Hector-S/ECE411-Practicum/Real-World Documentation/Board Assembled.jpg

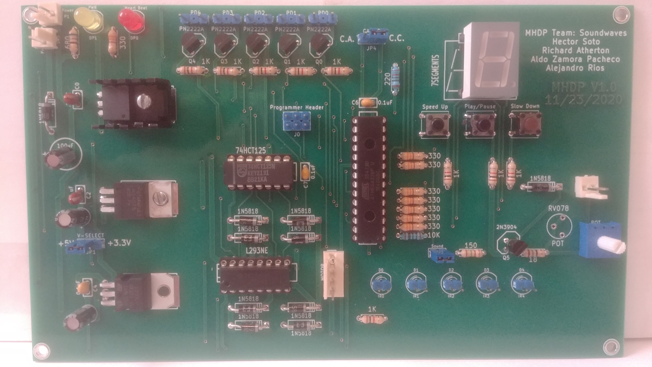
Real-World Documentation/Board Assembled.jpg
