Hector-S/ECE411-Practicum/Schematics/Final Project Schematic/MHDP_Layout_Quasi.JPG

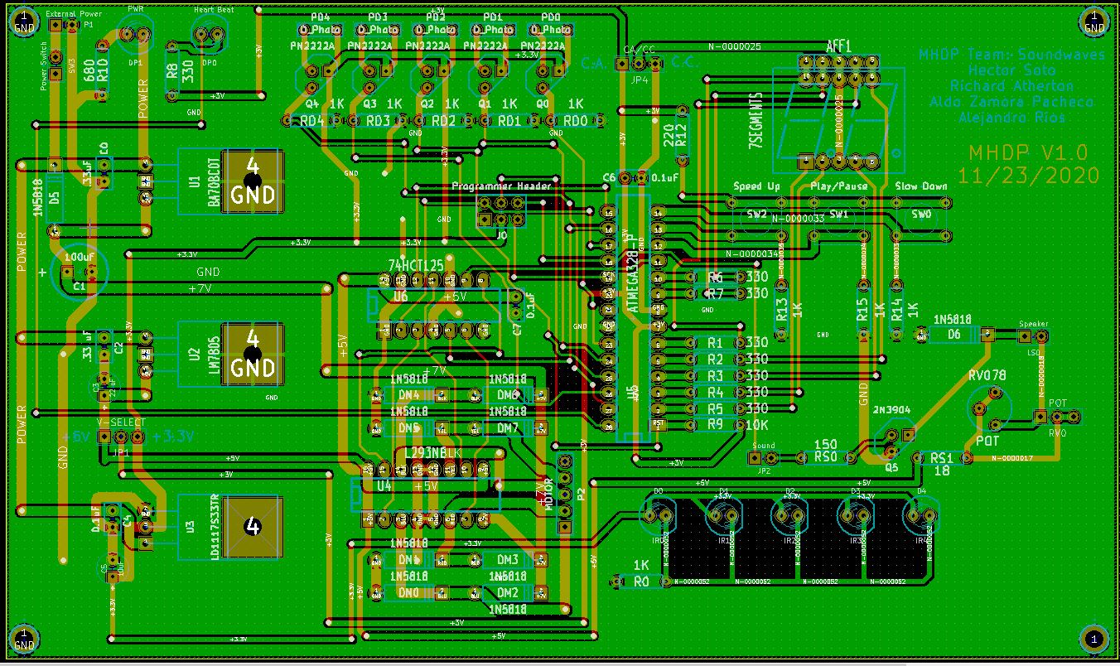
Schematics/Final Project Schematic/MHDP_Layout_Quasi.JPG
