Hector-S/ECE411-Practicum/README.md

# ECE411-Practicum
* **Team Members**
  * Aldo Zamora Pacheco
  * Alejandro (Alex) Rios
  * Hector Soto
  * Richard Atherton

License: GNU General Public License v3.0
