Hector-S/ECE411-Practicum/Documentation/Block Diagrams/MHDP Block Diagram.pdf

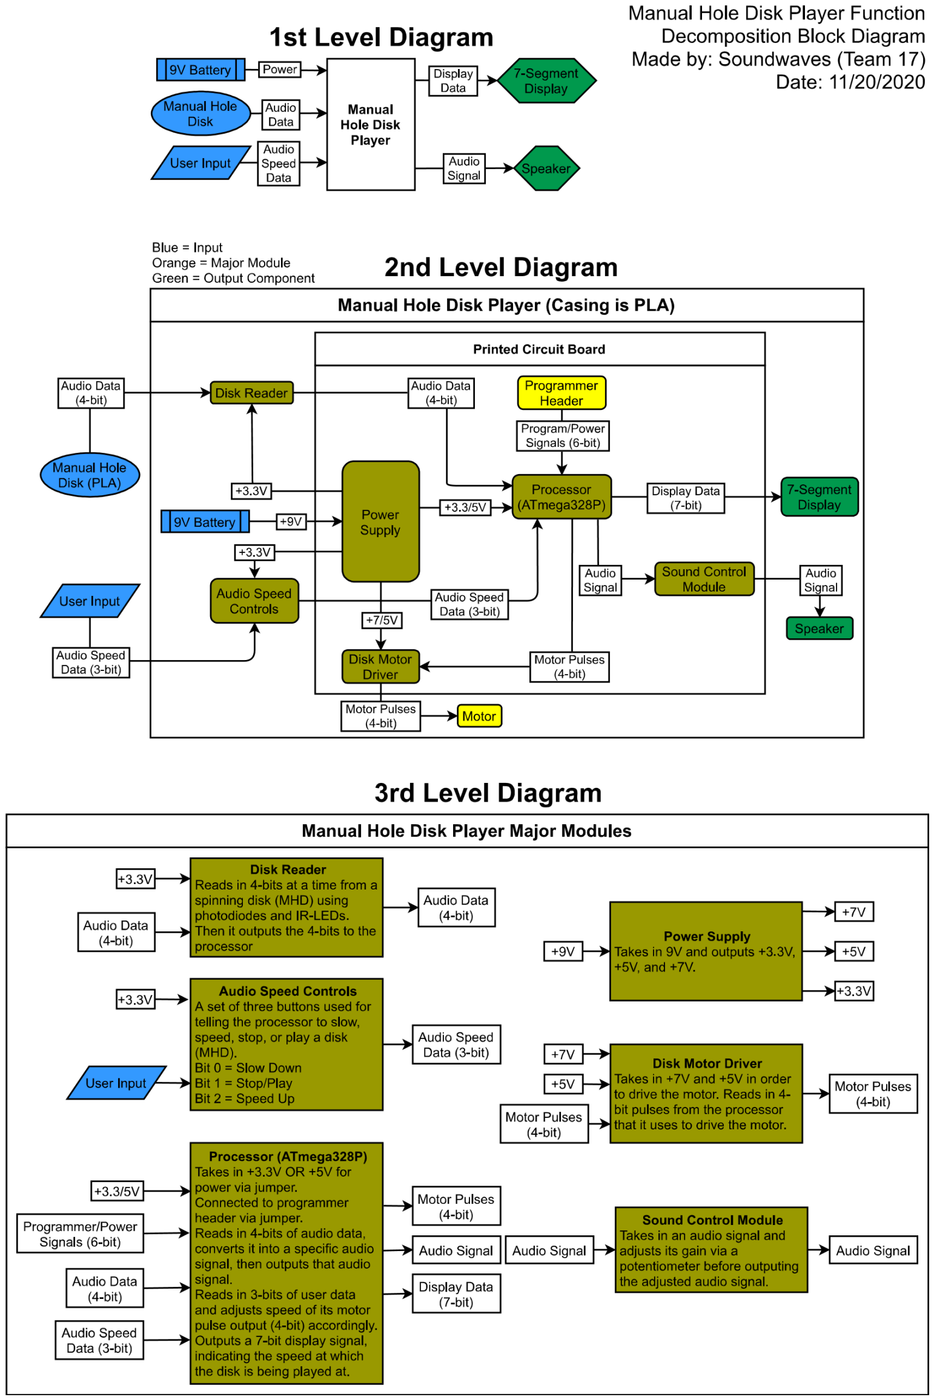
[picture p4: page 1]
