Hector-S/ECE411-Practicum/Circuit/SoundControl/IMG_8013.jpg

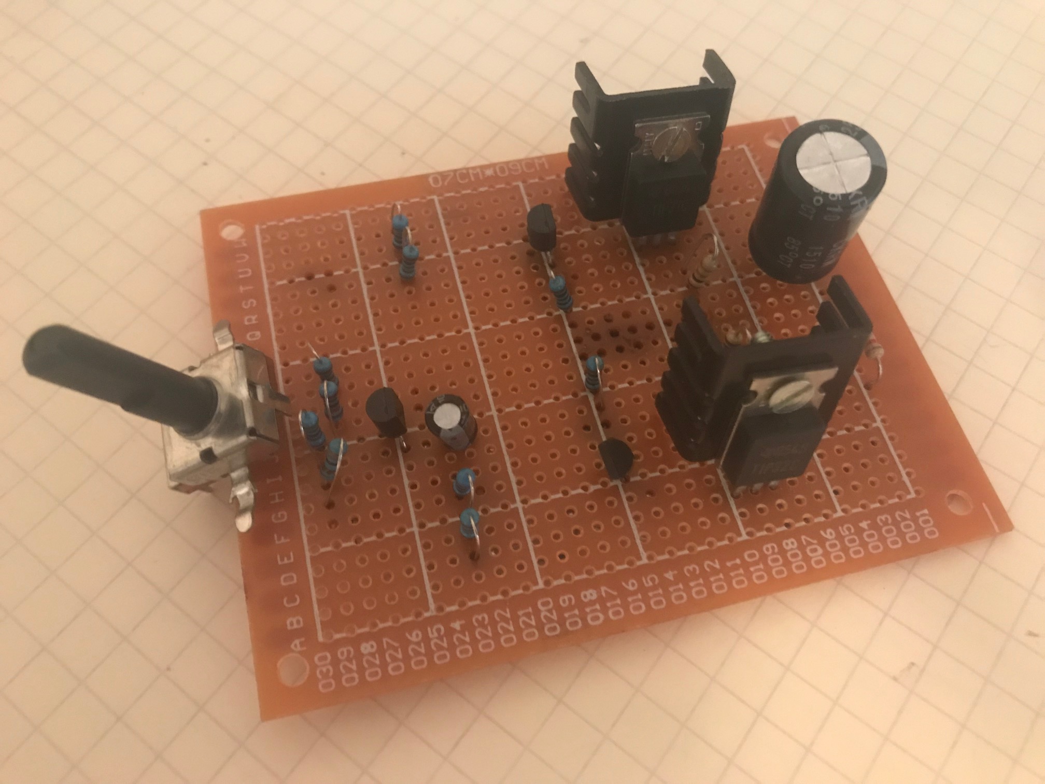
Circuit/SoundControl/IMG_8013.jpg
