Hector-S/ECE411-Practicum/Documentation/Block Diagrams/MHDP Block Diagram.jpg

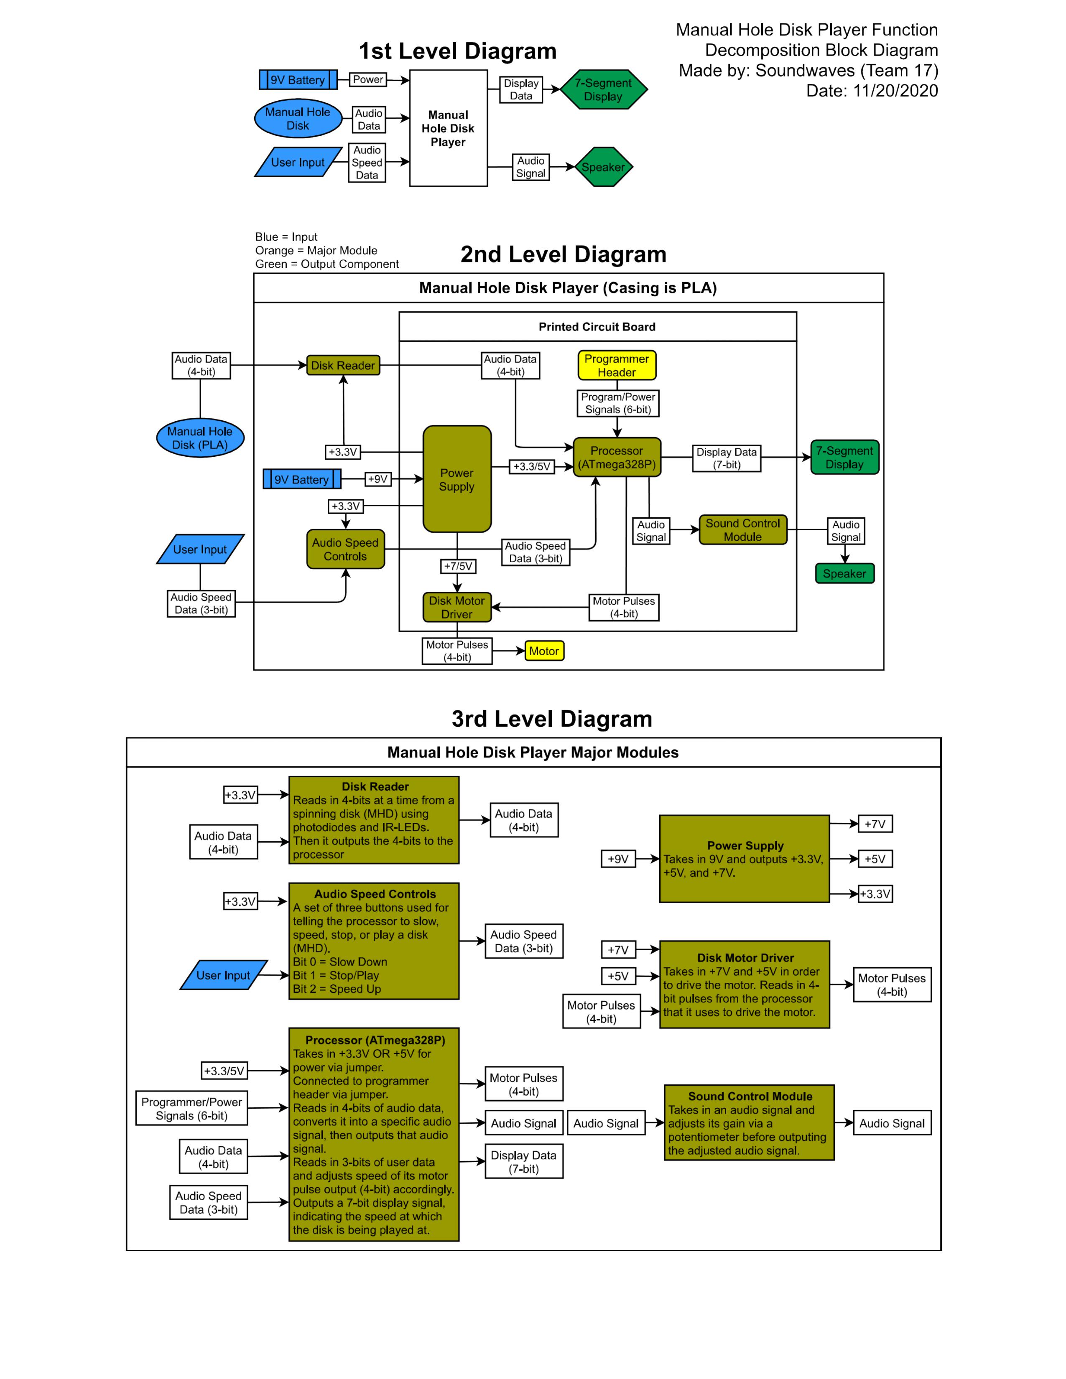
Documentation/Block Diagrams/MHDP Block Diagram.jpg
