Hector-S/ECE411-Practicum/Documentation/Block Diagrams/Motor Speed State Diagram.PNG

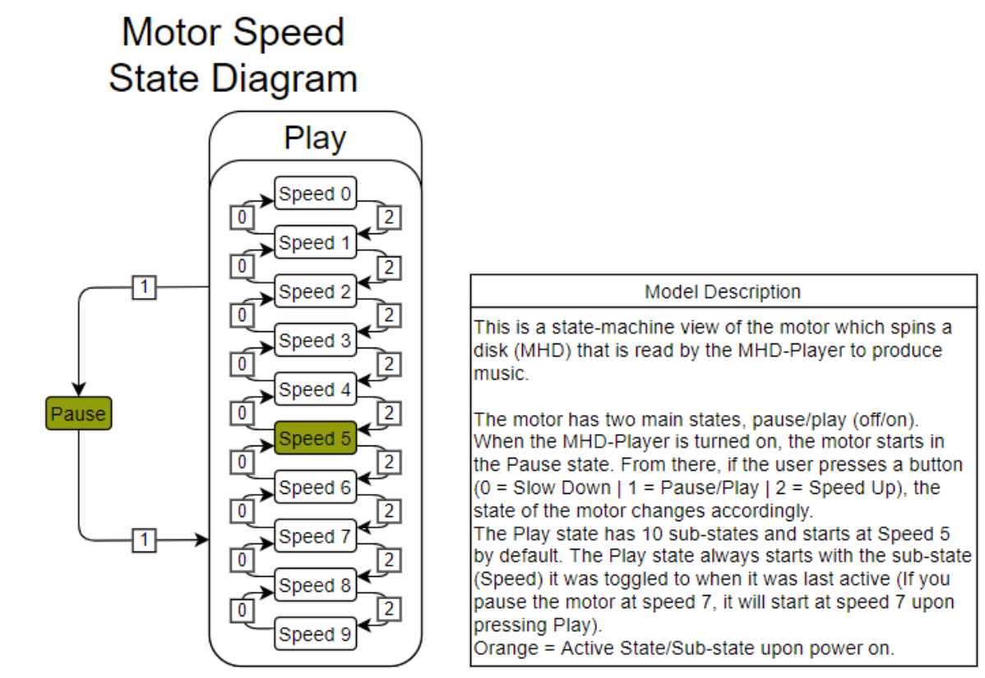
Documentation/Block Diagrams/Motor Speed State Diagram.PNG
