Hector-S/ECE411-Practicum/Real-World Documentation/Board Back.jpg

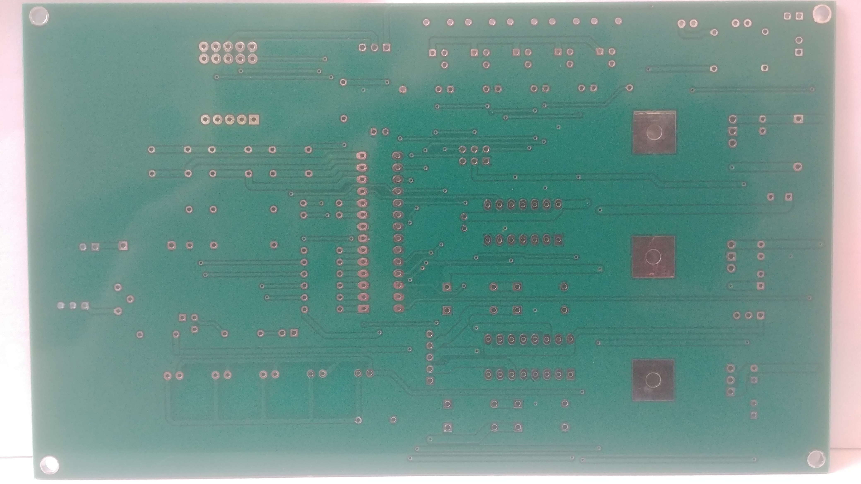
Real-World Documentation/Board Back.jpg
