Hector-S/ECE411-Practicum/Real-World Documentation/Board Front.jpg

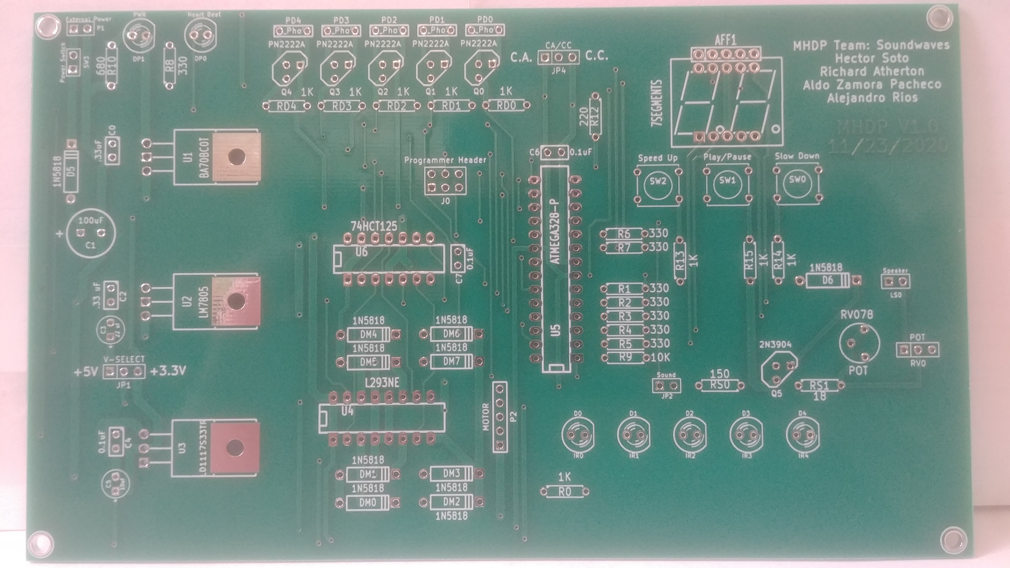
Real-World Documentation/Board Front.jpg
