Hector-S/ECE411-Practicum/Schematics/Beta Project Schematic/Rough_Draft_Schematic.jpg

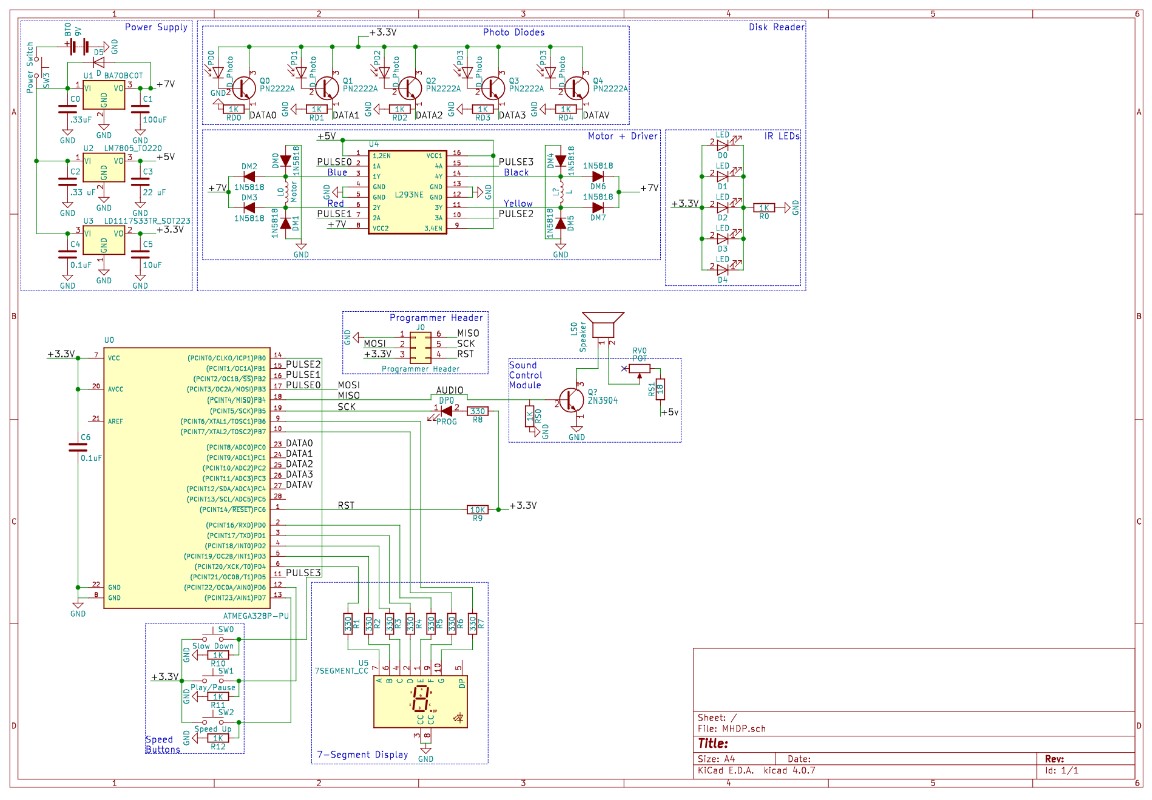
Schematics/Beta Project Schematic/Rough_Draft_Schematic.jpg
