Hector-S/ECE411-Practicum/Schematics/Complete Project Schematic.PNG

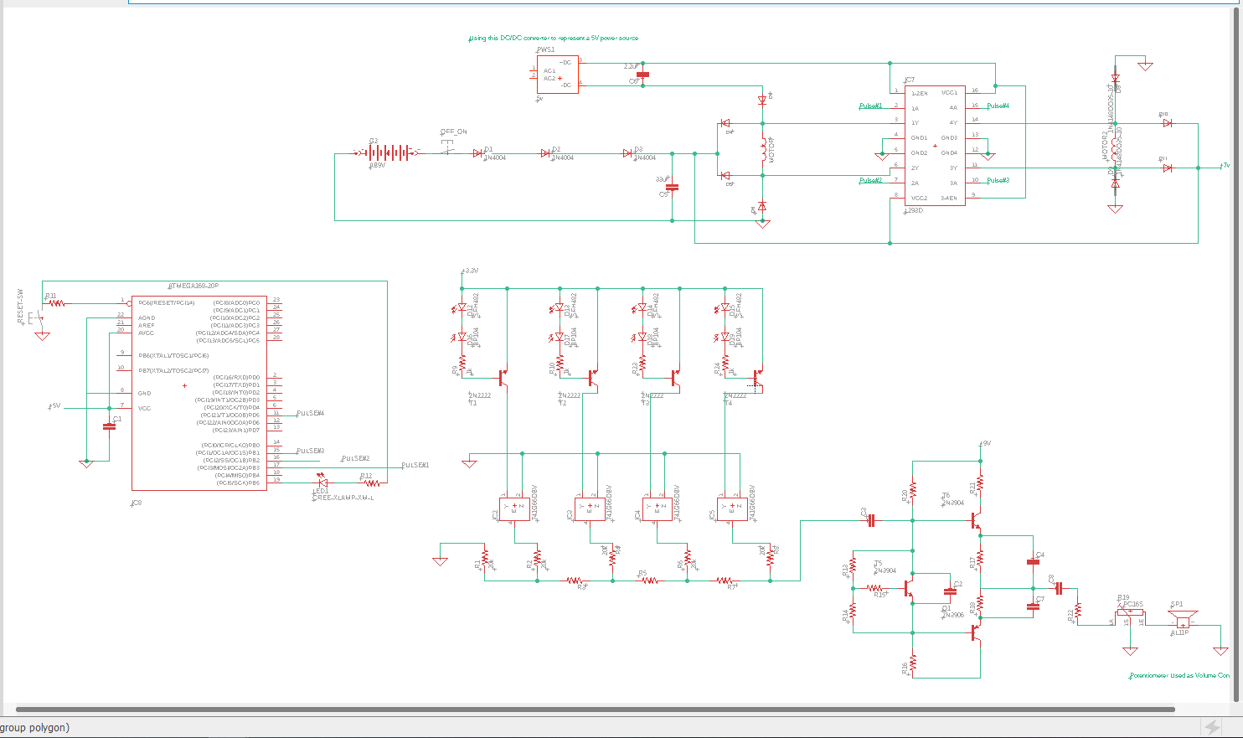
Schematics/Complete Project Schematic.PNG
