Hector-S/ECE411-Practicum/Schematics/Final Project Schematic/Final Schematic.png

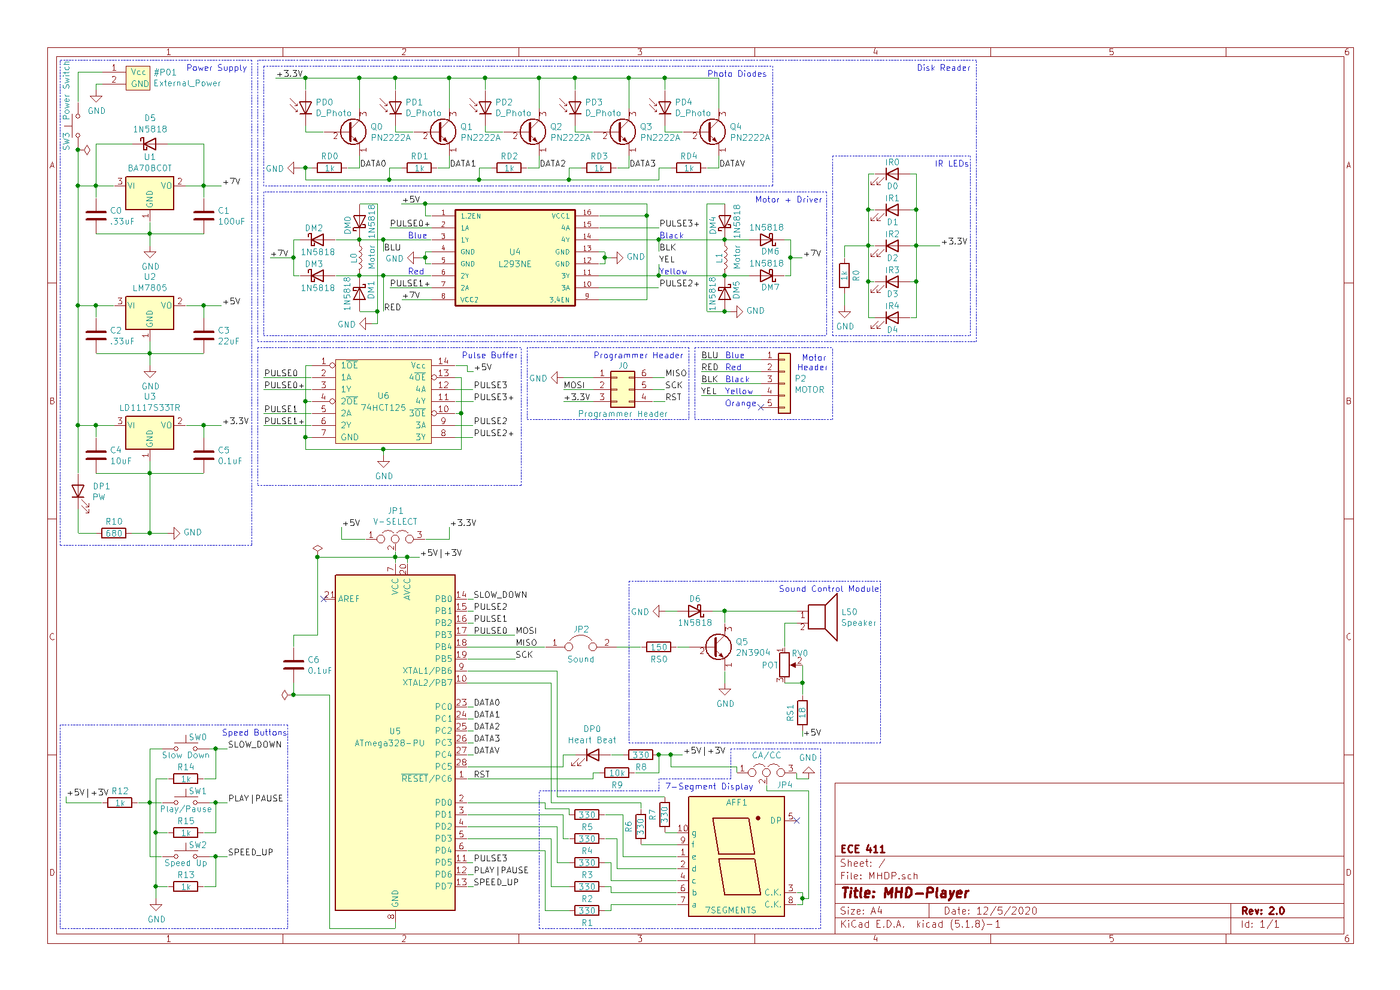
Schematics/Final Project Schematic/Final Schematic.png
