Hector-S/ECE411-Practicum/Schematics/Final Project Schematic/MHDP_Layout_Front.png

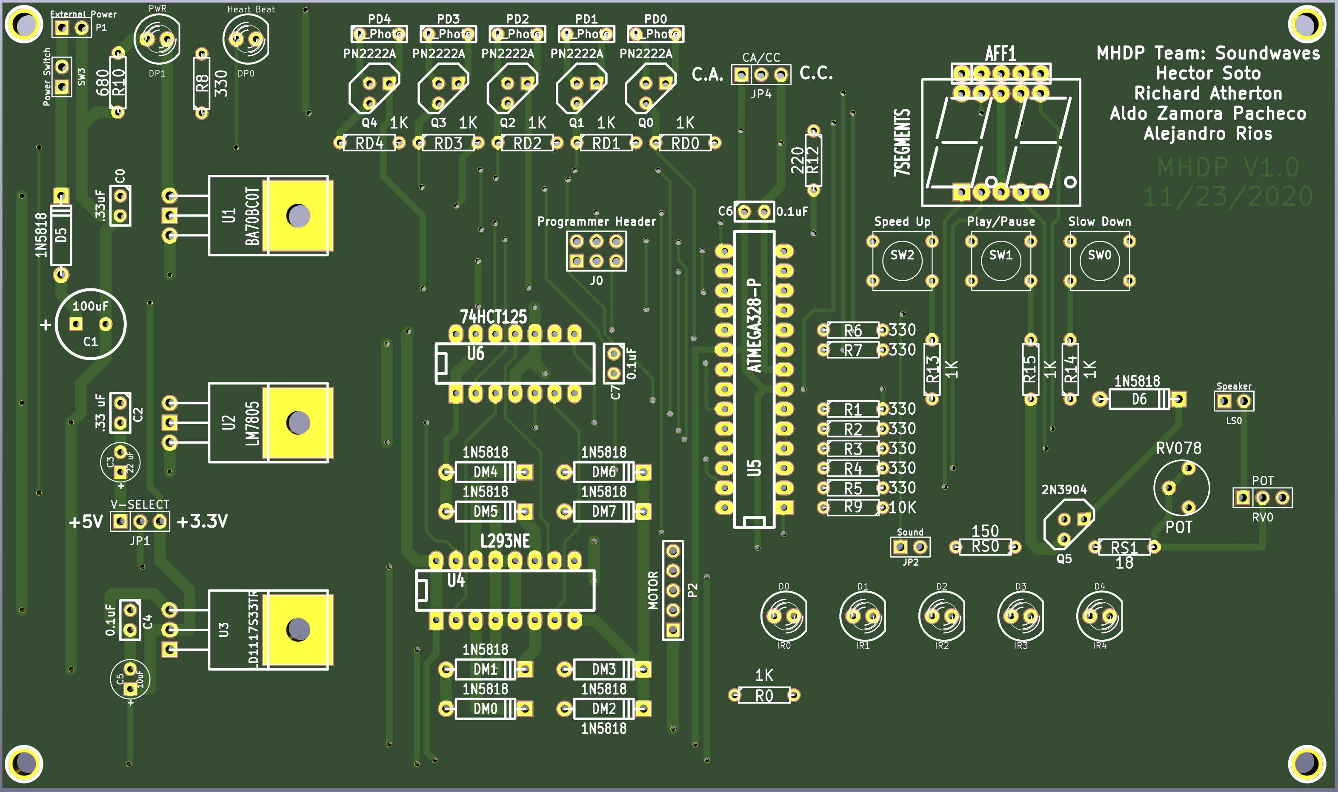
Schematics/Final Project Schematic/MHDP_Layout_Front.png
