Hector-S/ECE411-Practicum/Schematics/Final Project Schematic/MHDP_Layout_Rear.png

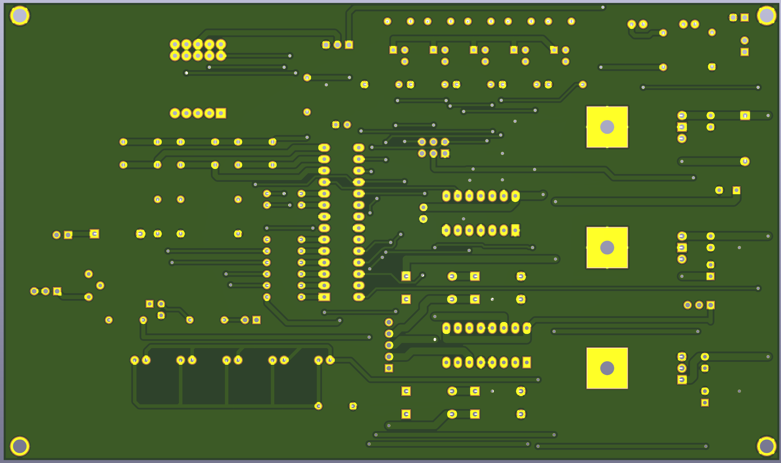
Schematics/Final Project Schematic/MHDP_Layout_Rear.png
