Hector-S/ECE411-Practicum/Documentation/BOM.PNG

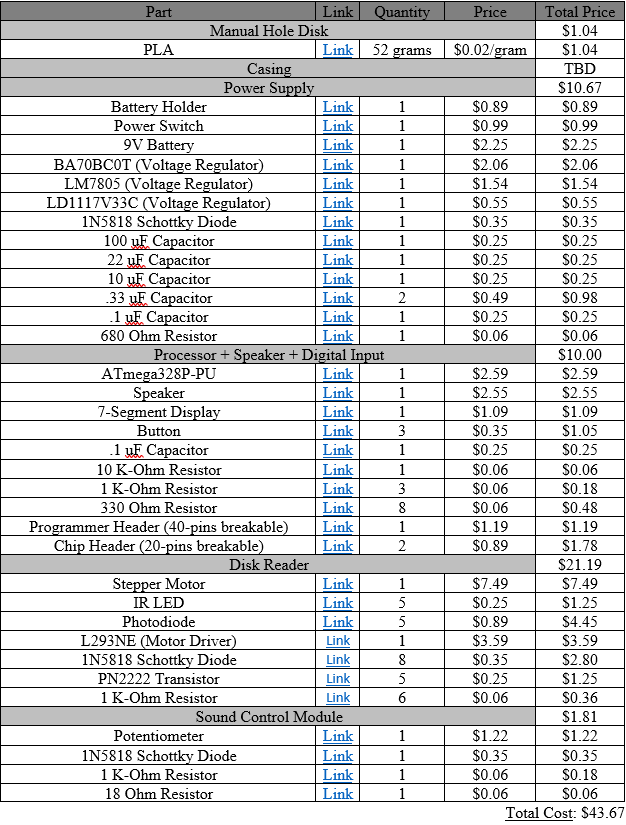
Documentation/BOM.PNG
