Hector-S/ECE411-Practicum/Schematics/Beta Project Schematic/BOM.jpg

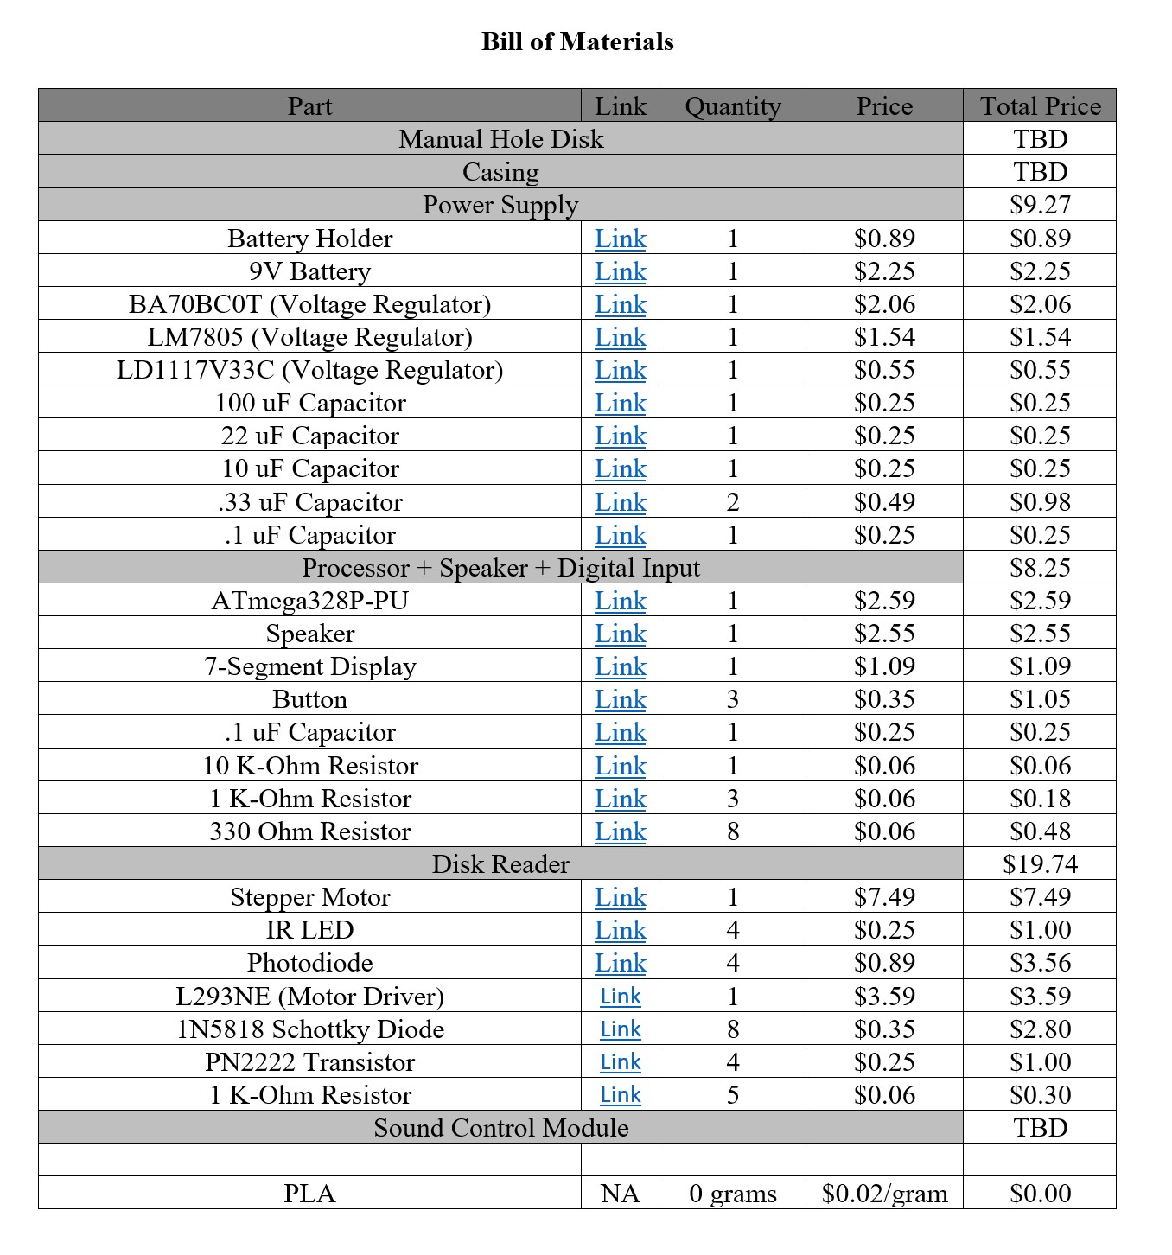
Schematics/Beta Project Schematic/BOM.jpg
