Hector-S/ECE411-Practicum/3D Models/Flap.stl

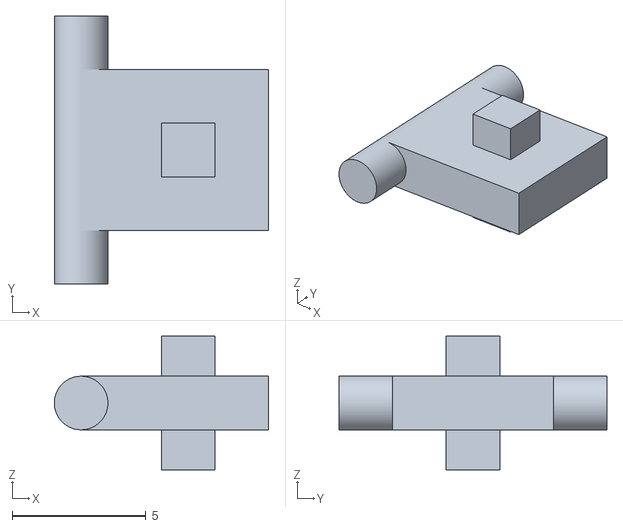
[picture p17: CAD file, 2020-12-05]
3D Models/Flap.stl
8.00 x 10.0 x 5.00
