Hector-S/ECE411-Practicum/Schematics/Beta Project Schematic/L293NE/L293NE.step

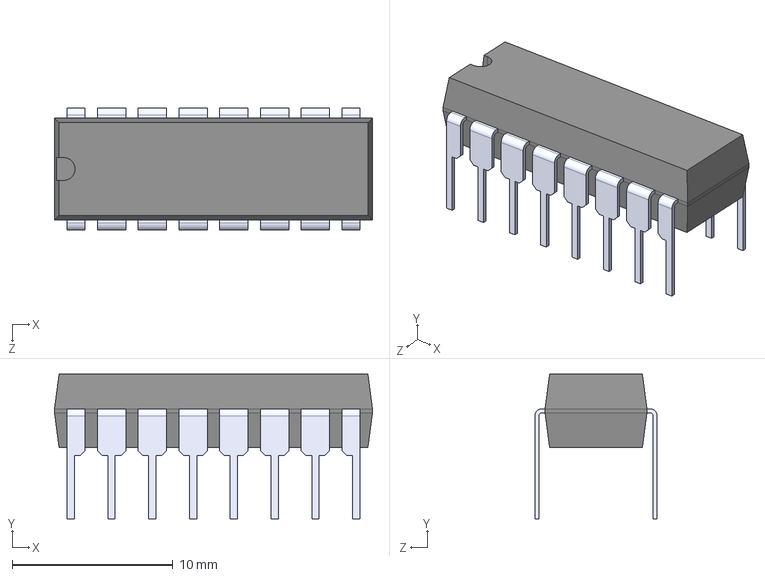
[picture p18: CAD file, 2020-11-18]
Schematics/Beta Project Schematic/L293NE/L293NE.step
19.8 x 9.02 x 7.62 mm
