Hector-S/ECE411-Practicum/3D Models/Disk Lower Half.stl

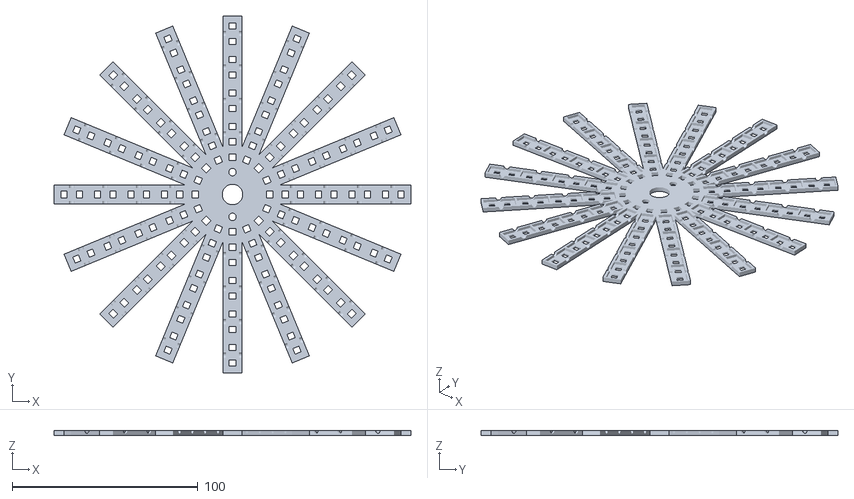
[picture p19: CAD file, 2020-12-05]
3D Models/Disk Lower Half.stl
192.0 x 192.0 x 2.50
