Hector-S/ECE411-Practicum/3D Models/Disk Top Half.stl

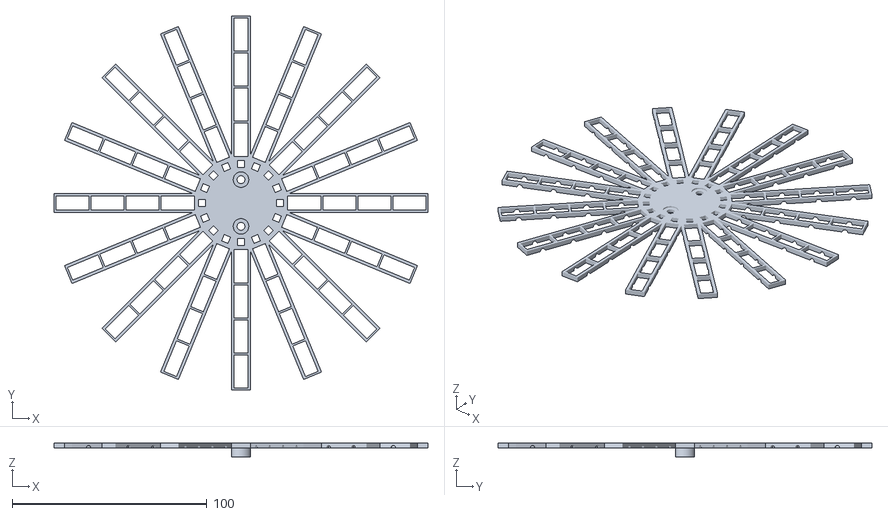
[picture p20: CAD file, 2020-12-05]
3D Models/Disk Top Half.stl
192.0 x 192.0 x 7.00
