Hector-S/ECE411-Practicum/Schematics/Stepper Motor Schematic.pdf

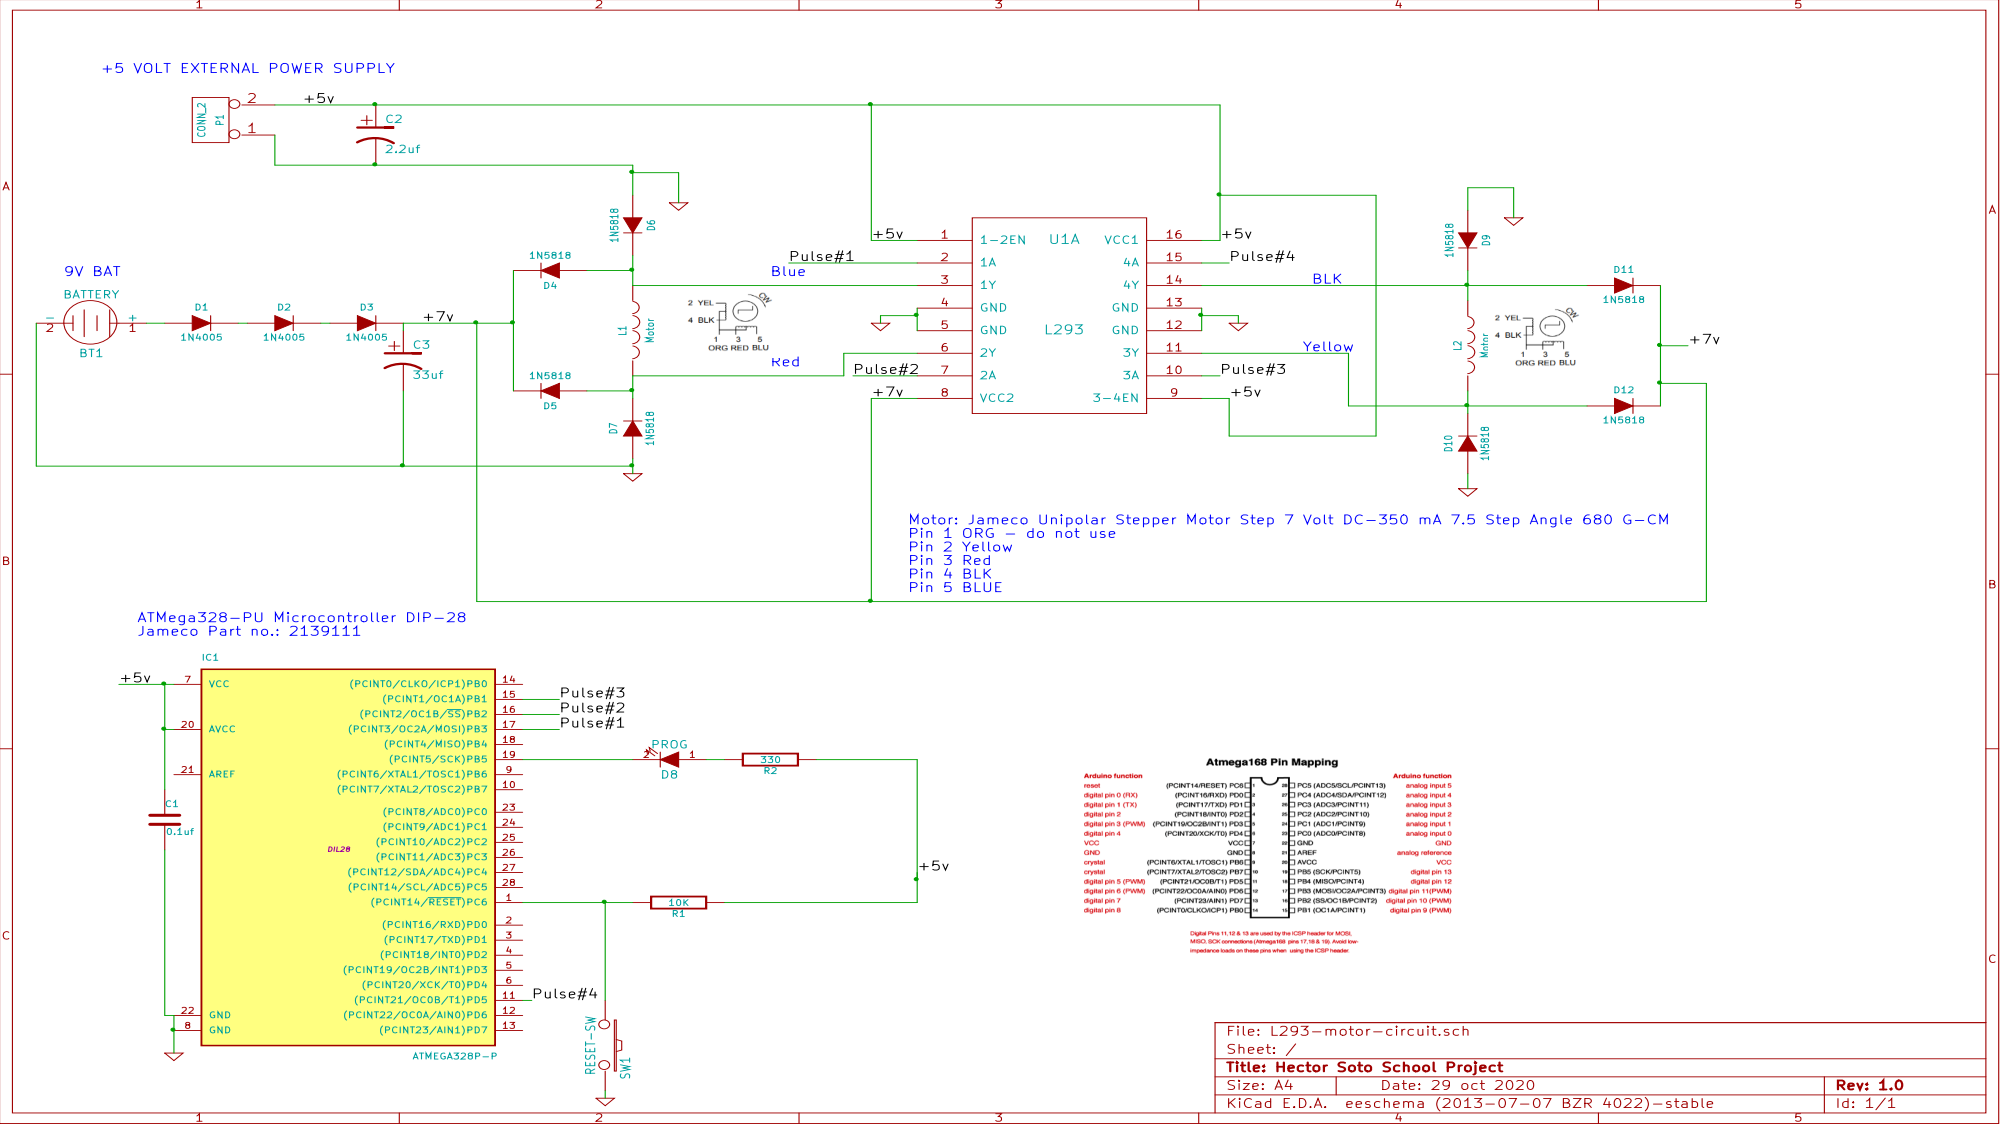
[picture p21: page 1]
