Hector-S/ECE411-Practicum/Schematics/Final Project Schematic/Final Project Schematic.pdf

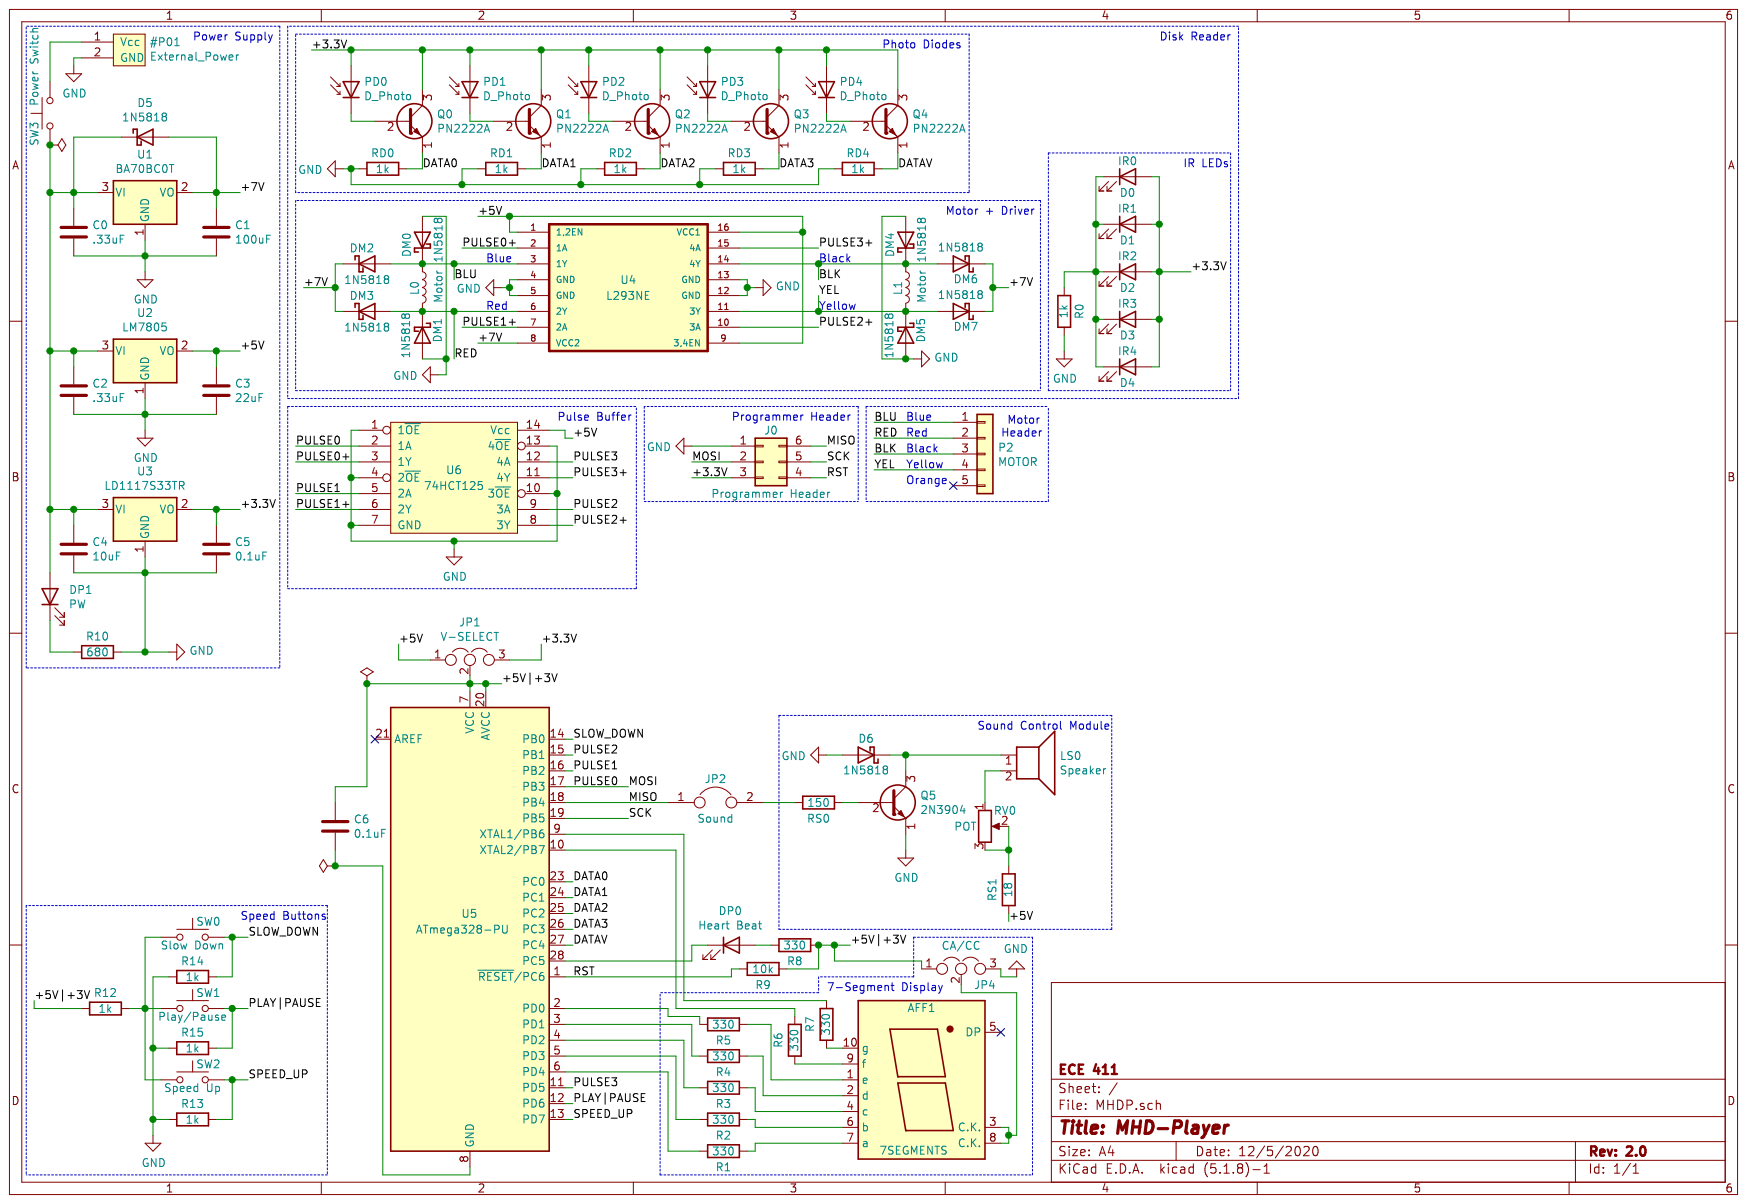
[picture p22: page 1]
