Hector-S/ECE411-Practicum/Schematics/Beta Project Schematic/Final Project Schematic.pdf

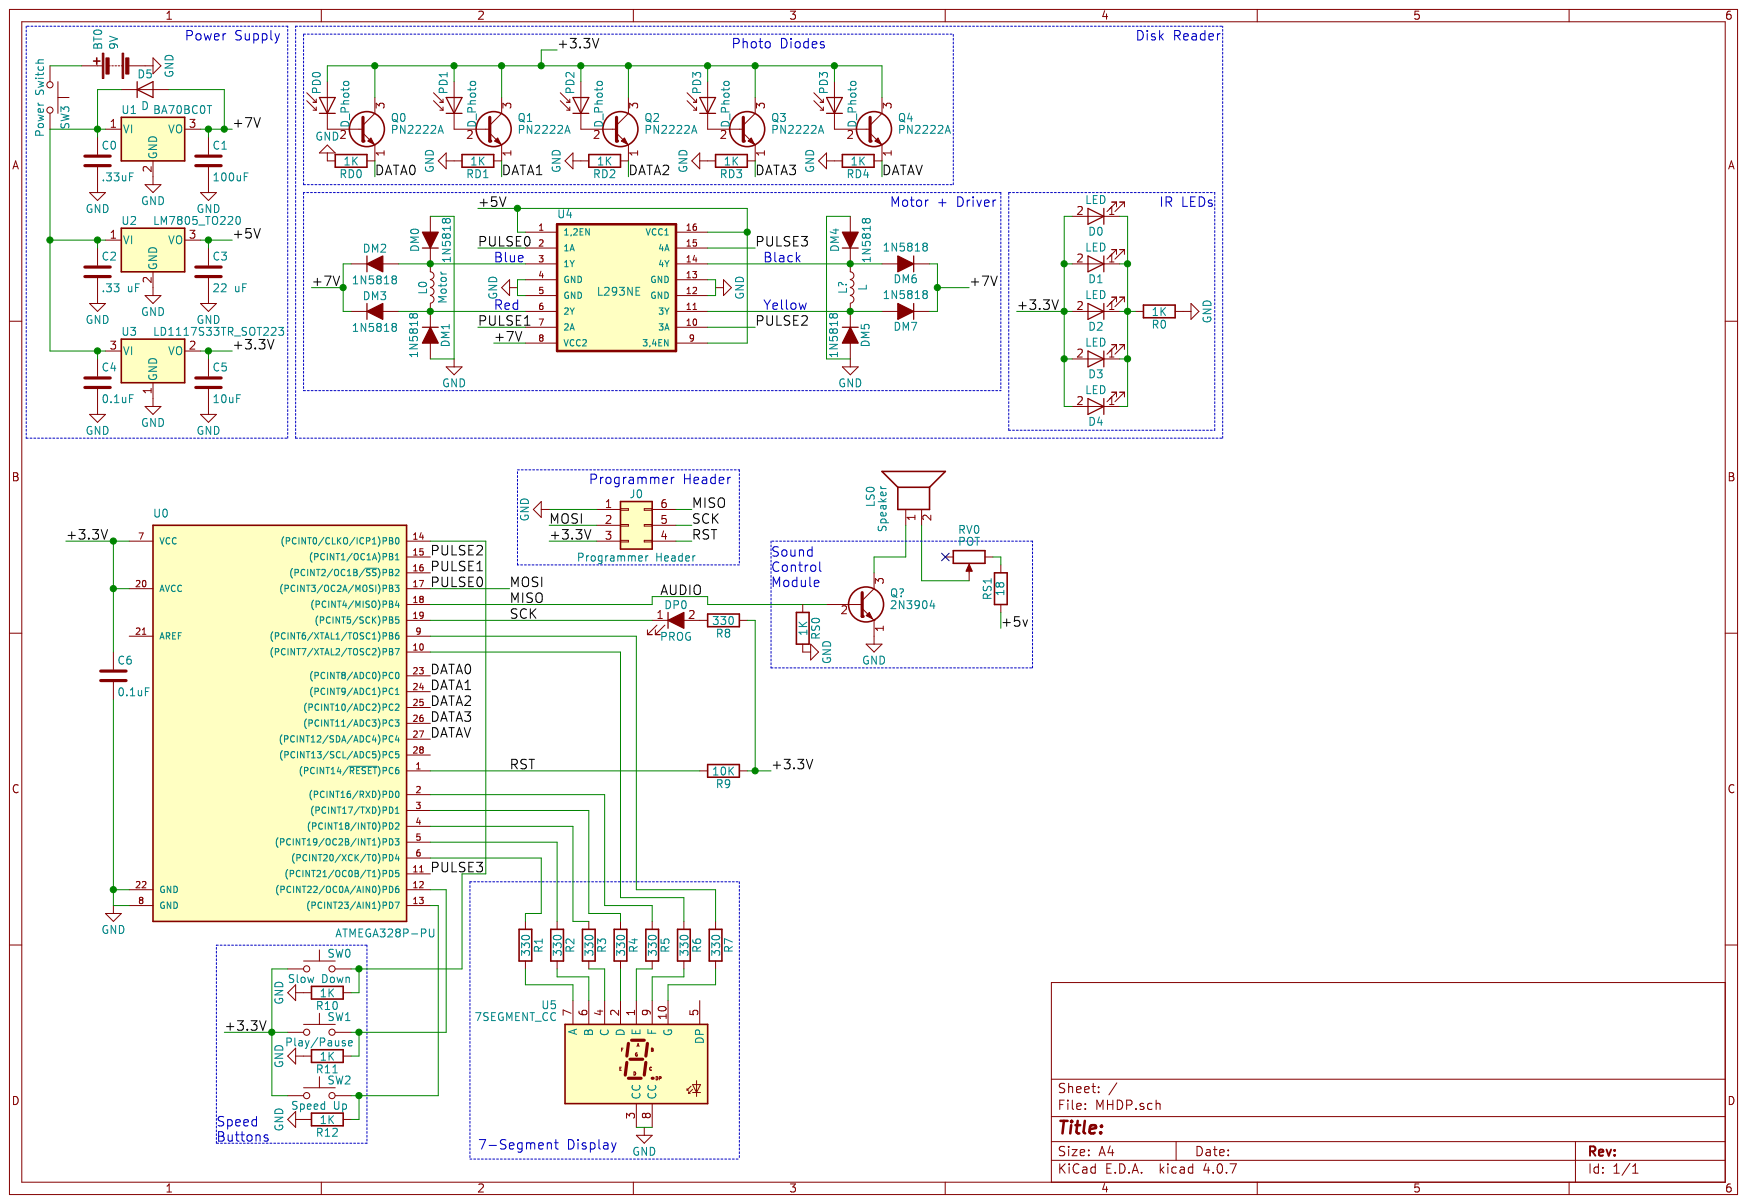
[picture p23: page 1]
