Hector-S/ECE411-Practicum/Documentation/Product Design Specification/Team17_PDS.pdf

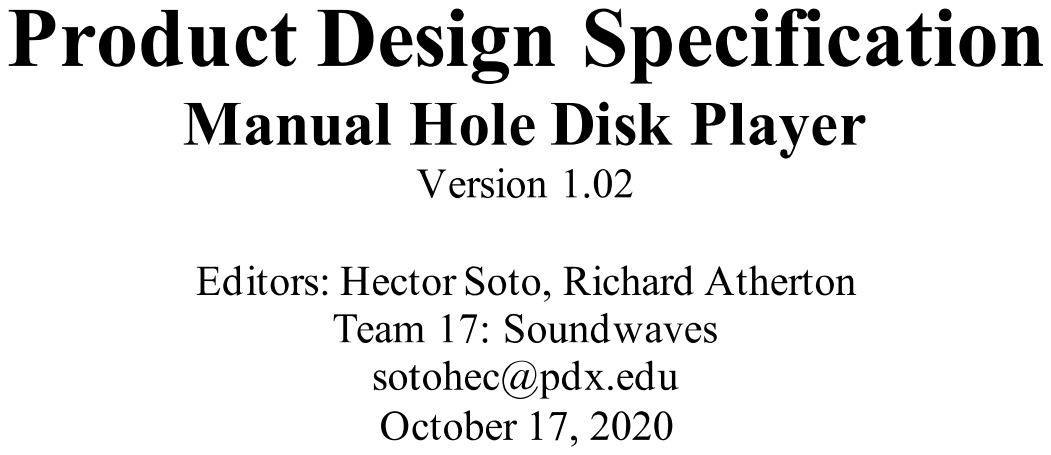
[picture p24: page 1]

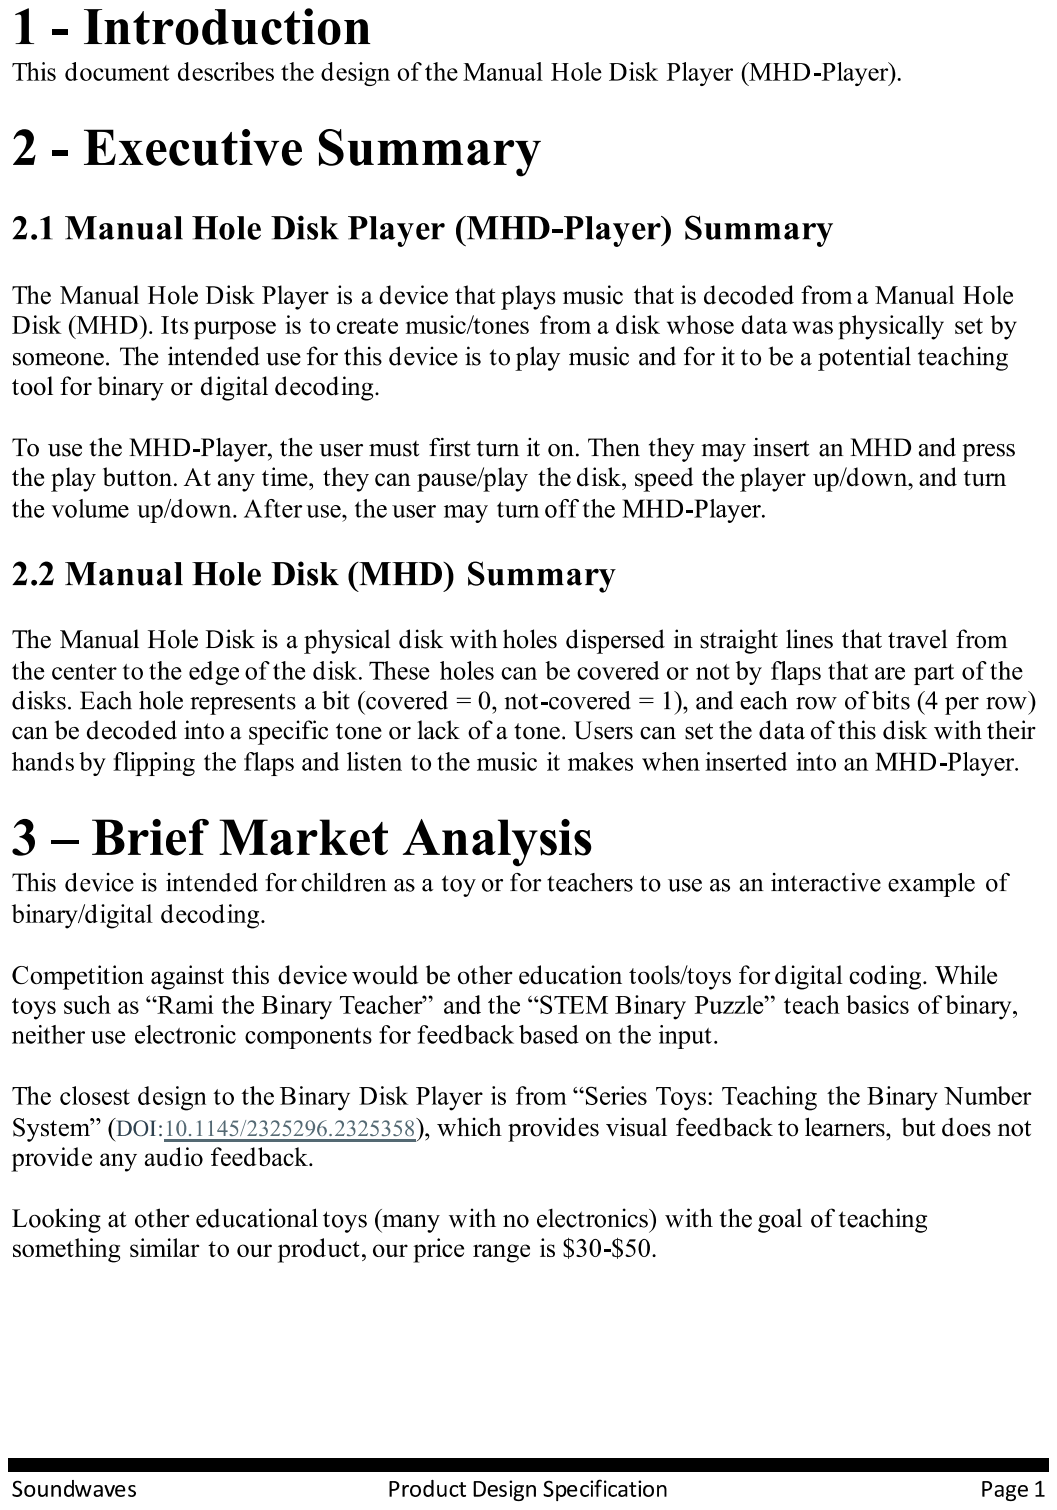
[picture p25: page 2]

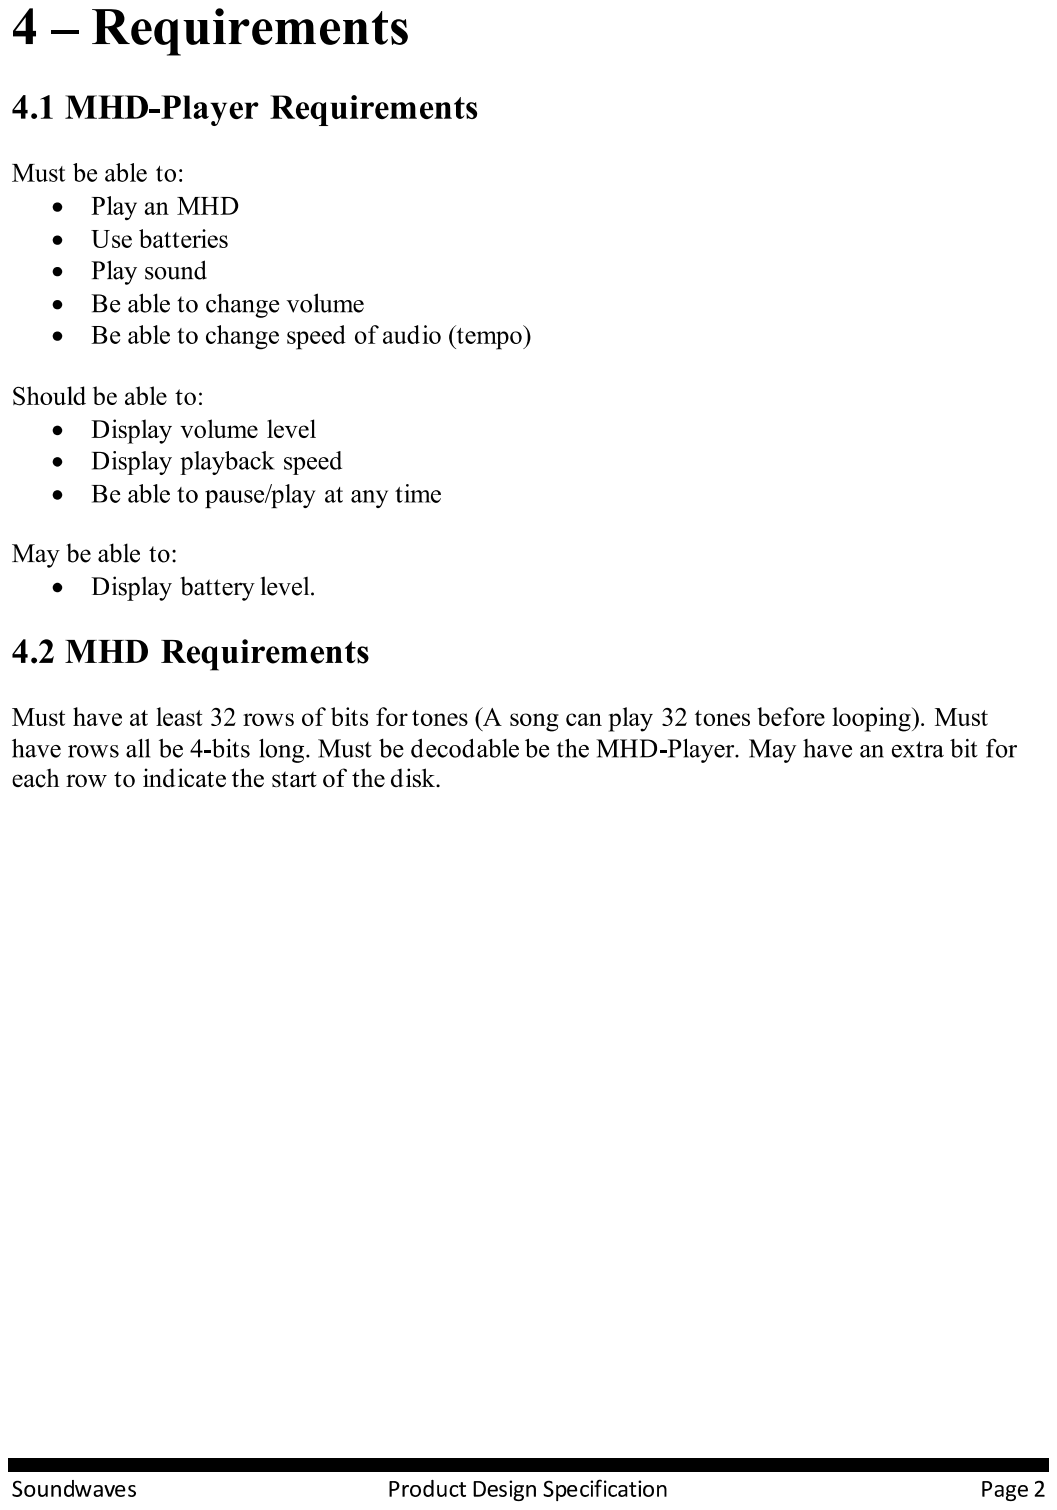
[picture p26: page 3]

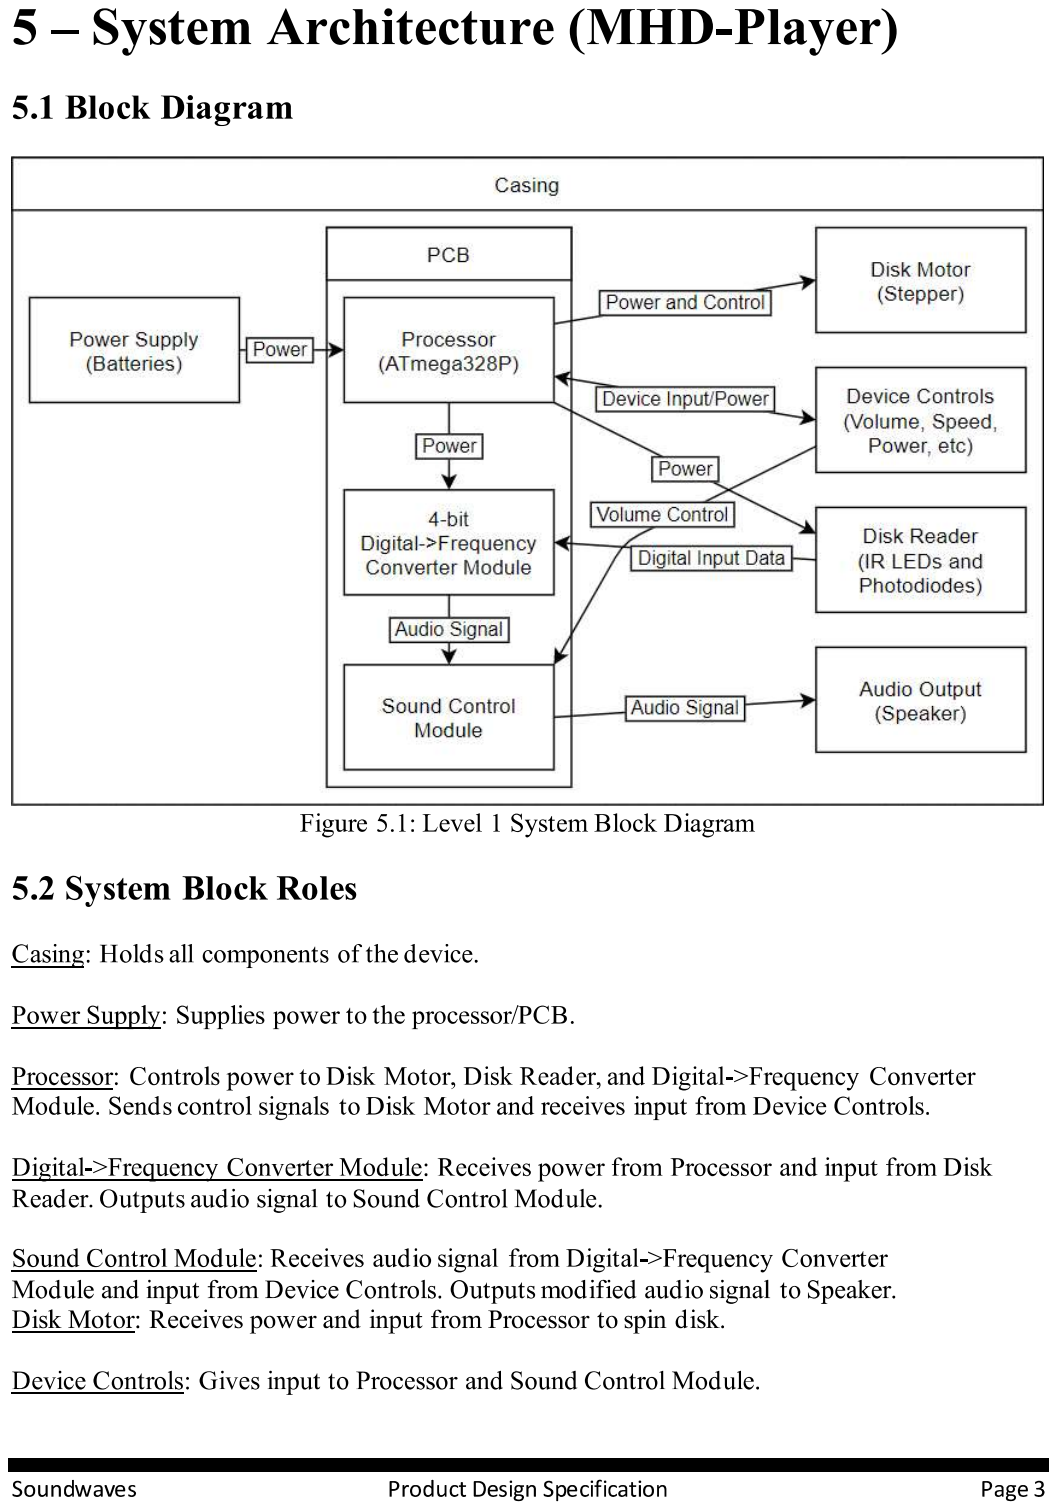
[picture p27: page 4]

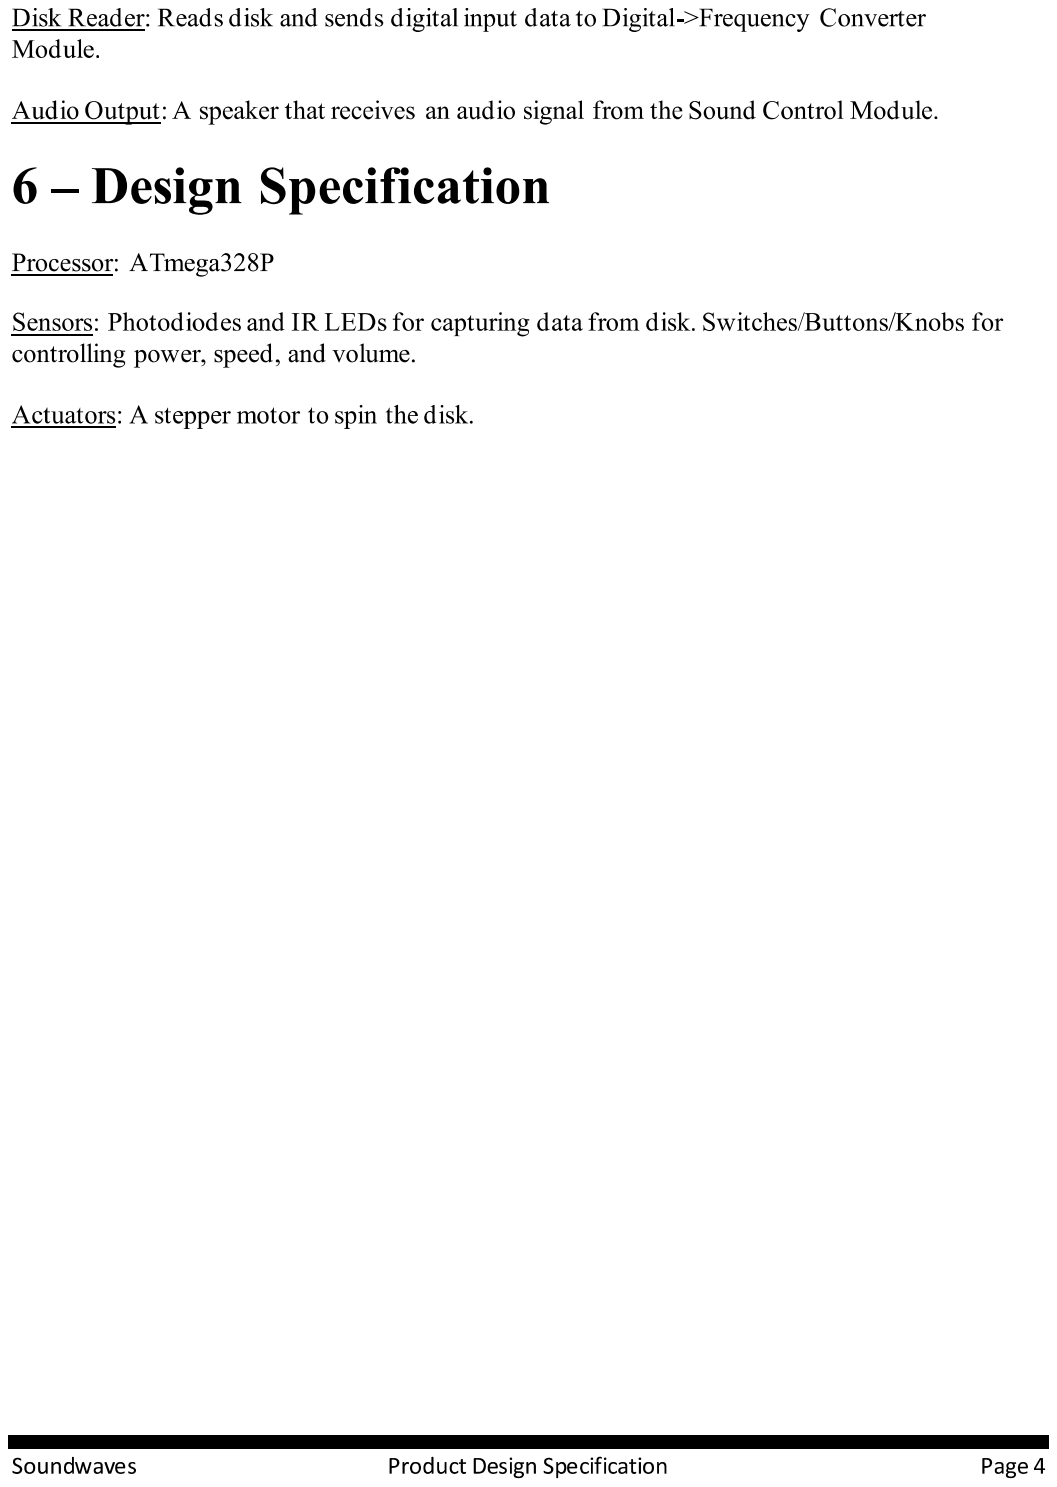
[picture p28: page 5]
