Hector-S/ECE411-Practicum/Circuit/SoundControl/411SoundControlAB_270mW_9V.asc

C1: cap; 100µ
C2: cap; 1000µ
C3: cap; 1000µ
C4: cap; 470µ
C5: cap; 10µ
Q1: pnp; 2N3906
Q2: npn; 2N3904
Q3: npn; 2N3904
R1: res; 40k
R2: res; 10k
R3: res; 5.2k
R4: res; 40k
R5: res; 20
R6: res; 20
R7: res; 50k
R8: res; 1
R9: res; 1
Rload: res; 8
V1: voltage; 9
V2: voltage; SINE(0 3.3 1k)
Named nets: 0, Vcc, Vin
.tran 0 .9 .89
