Hector-S/ECE411-Practicum/Circuit/SoundControl/411SoundControl_DualSupply.asc

C1: cap; 100µ
C2: cap; 1000µ
C3: cap; 1000µ
C4: cap; 470µ
C5: cap; 10µ
Q1: pnp; 2N3906
Q2: npn; 2N3904
Q3: npn; 2N3904
R1: res; 4k
R2: res; 10k
R3: res; 5.2k
R4: res; 4k
R5: res; 20
R6: res; 20
R8: res; 1
R9: res; 1
Rload: res; 8
V1: voltage; 4
V2: voltage; SINE(0 3.3 1k)
V3: voltage; 4
Named nets: 0, Vcc, Vin
.tran 0 .9 .89
