Hector-S/ECE411-Practicum/Schematics/Beta Project Schematic/MHDP.kicad_pcb

## KiCad design kicad/jenga_jiggler/jenga_jiggler.sch

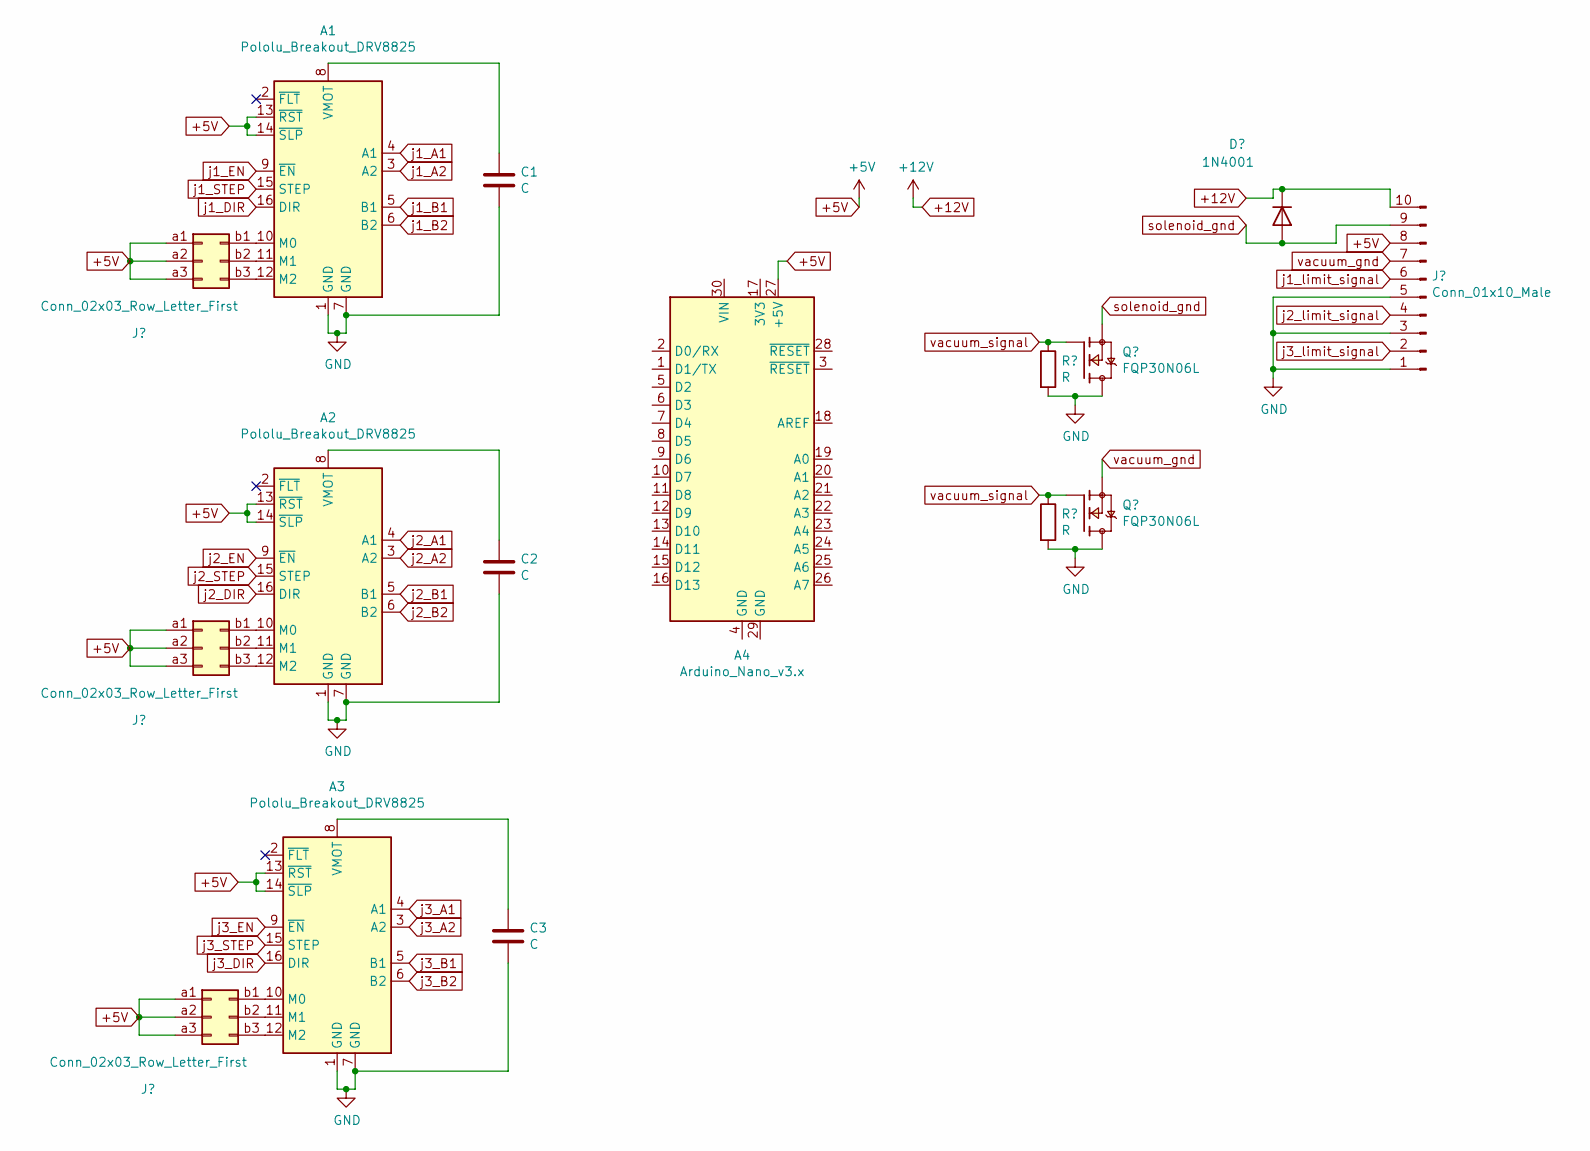
[picture p29: schematic jenga_jiggler.sch]

Parts:
A1, A2, A3: Pololu_Breakout_DRV8825; Pololu_Breakout-16_15.2x20.3mm
A4: Arduino_Nano_v3.x; Arduino_Nano
C1, C2, C3: C

Connections:
+5V: A1.13 (~RST), A1.14 (~SLP), A2.13 (~RST), A2.14 (~SLP), A3.13 (~RST), A3.14 (~SLP), A4.27 (+5V)
GND: A1.1 (GND), A1.7 (GND), A2.1 (GND), A2.7 (GND), A3.1 (GND), A3.7 (GND), C1.2, C2.2, C3.2
unnamed: A1.8 (VMOT), C1.1
unnamed: A2.8 (VMOT), C2.1
unnamed: A3.8 (VMOT), C3.1
j1_A1: A1.4 (A1)
j1_A2: A1.3 (A2)
j1_B1: A1.5 (B1)
j1_B2: A1.6 (B2)
j1_DIR: A1.16 (DIR)
j1_EN: A1.9 (~EN)
j1_STEP: A1.15 (STEP)
j2_A1: A2.4 (A1)
j2_A2: A2.3 (A2)
j2_B1: A2.5 (B1)
j2_B2: A2.6 (B2)
j2_DIR: A2.16 (DIR)
j2_EN: A2.9 (~EN)
j2_STEP: A2.15 (STEP)
j3_A1: A3.4 (A1)
j3_A2: A3.3 (A2)
j3_B1: A3.5 (B1)
j3_B2: A3.6 (B2)
j3_DIR: A3.16 (DIR)
j3_EN: A3.9 (~EN)
j3_STEP: A3.15 (STEP)
