Hector-S/ECE411-Practicum/(commit log)

2020-10-26 Create README.md
    Circuit folder created
2020-10-26 Add files via upload
    Basic symmetrical pair of npn/pnp transistors to boost current to speaker. Needs previous op-amp stage for voltage boost. PNP not turning on unless collector is set to -Vcc instead of ground currently and needs to be fixed.
2020-10-31 Add Stepper Motor Prototype Schematic
2020-11-02 Current sound control
2020-11-02 Add complete project schematic
    [Complete Project Schematic.sch]
2020-11-02 Delete 411SoundControl.asc
    Moved sound control to dedicated folder in /Circuit/
2020-11-02 Delete 411SoundControlAB.asc
    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
2020-11-07 Design to prototype.
    Check readme for more info
2020-11-18 Add BOM + Update Project Schematic
    [Complete Project Schematic.sch, L293NE.step, MHDP.kicad_pcb, MHDP.sch]
2020-11-18 Update Schematic + BOM
2020-11-19 Update schematic labels for motor pin colors
    [MHDP.sch]
2020-11-19 Update schematic
    [MHDP.sch]
2020-11-19 JPG of schematic for wiki
2020-11-19 BOM for Wiki
2020-12-05 Update Schematic + Docs + 3D Models
    Updates final project schematic, BOM, and adds 3D models for the MHD.
    [Disk Lower Half.stl, Disk Top Half.stl, Flap.stl, L293NE.step, MHDP.kicad_pcb, MHDP.sch]
2020-12-05 Add BOM image
2020-12-05 Downsize "Motor Demo.mp4"
2020-12-05 Add png version of final project schematic
